CuriousMotor/Onyx-Stepper-Motherboard/Hardware/KiCAD Files/Onyx PCB Picture.png

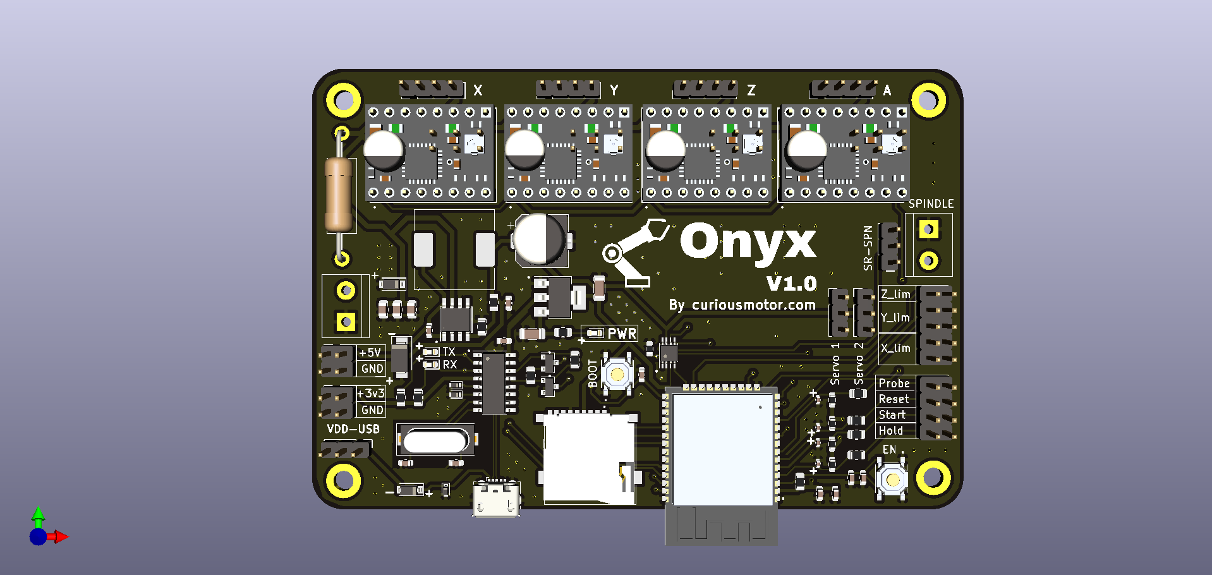
Hardware/KiCAD Files/Onyx PCB Picture.png
