CuriousMotor/Onyx-Stepper-Motherboard/Hardware/KiCAD Files/Resources/3D files/ESP32-WROOM-32D.step

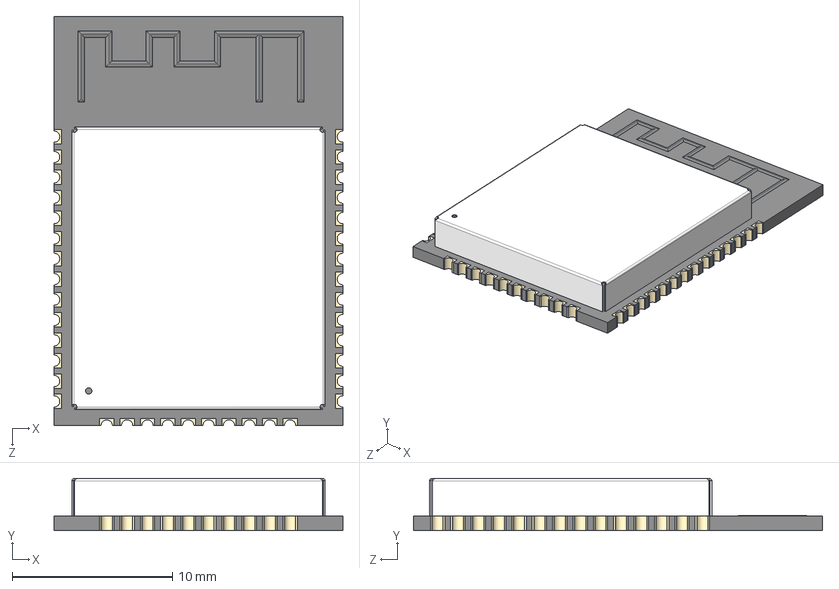
[picture p5: CAD file, 2021-12-19]
Hardware/KiCAD Files/Resources/3D files/ESP32-WROOM-32D.step
18.0 x 3.25 x 25.5 mm
