CuriousMotor/Onyx-Stepper-Motherboard/Hardware/KiCAD Files/Resources/ESP32-WROOM-32E__16MB_/ESP32-WROOM-32E__16MB_.step

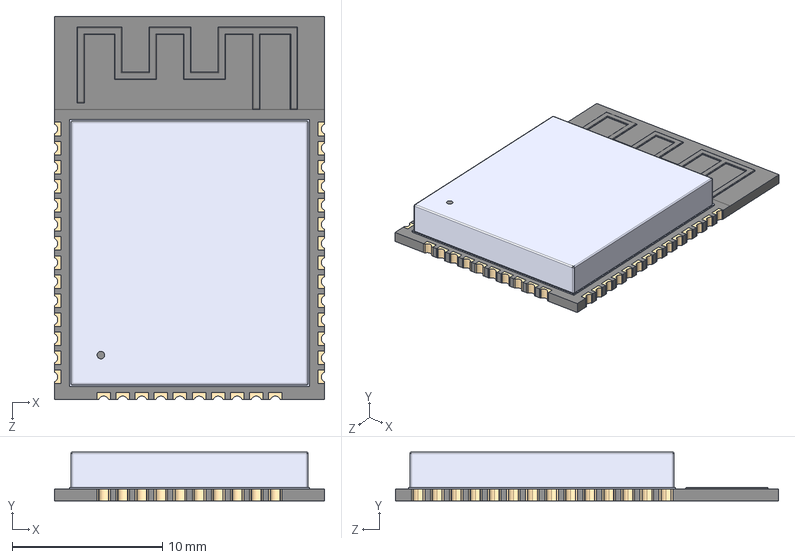
[picture p6: CAD file, 2021-12-19]
Hardware/KiCAD Files/Resources/ESP32-WROOM-32E__16MB_/ESP32-WROOM-32E__16MB_.step
18.0 x 3.25 x 25.5 mm
