CuriousMotor/Onyx-Stepper-Motherboard/Hardware/KiCAD Files/Resources/3D files/A4988_STEPPER_MOTOR_DRIVER_CARRIER.step

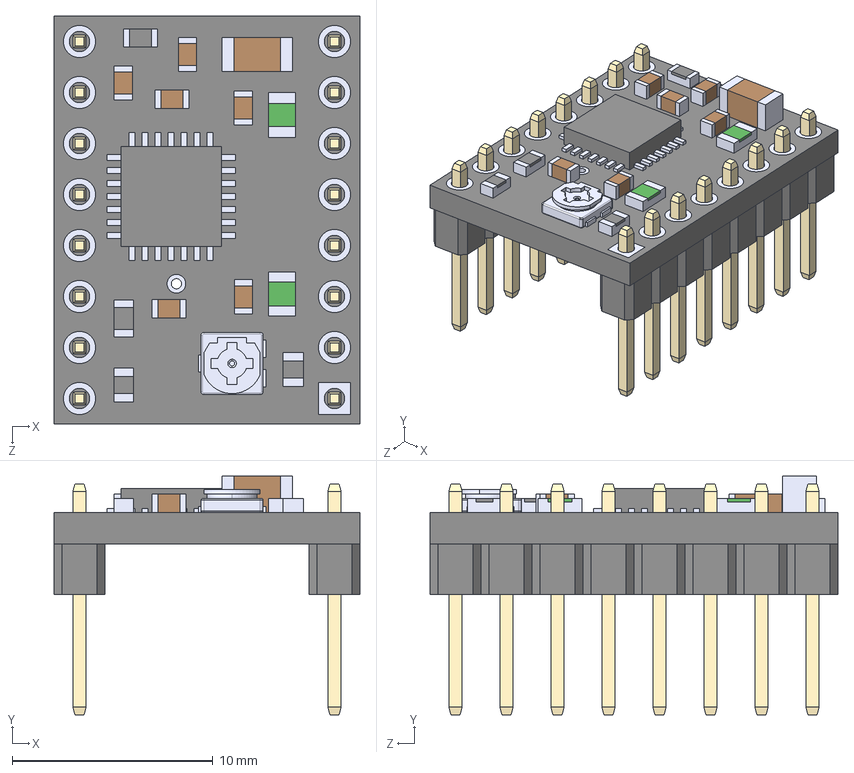
[picture p7: CAD file, 2021-12-19]
Hardware/KiCAD Files/Resources/3D files/A4988_STEPPER_MOTOR_DRIVER_CARRIER.step
15.2 x 11.9 x 20.3 mm
