CuriousMotor/Onyx-Stepper-Motherboard/Hardware/KiCAD Files/Resources/3D files/TS-1187A-B-A-B.step

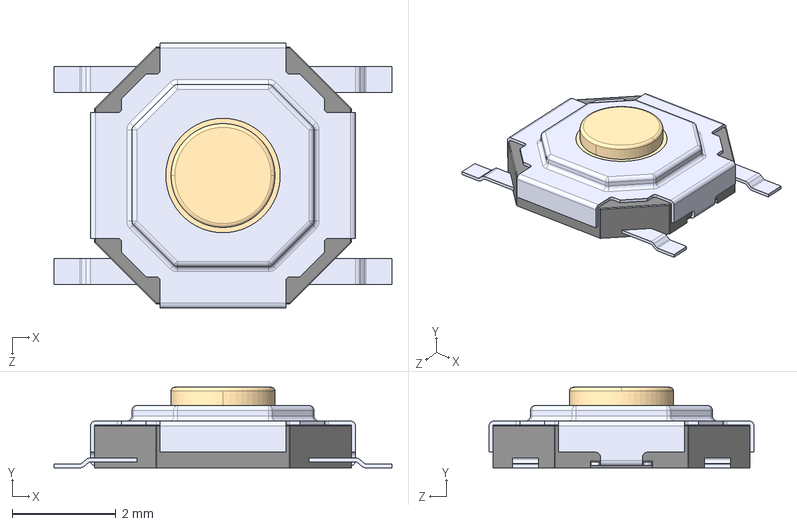
[picture p8: CAD file, 2021-12-19]
Hardware/KiCAD Files/Resources/3D files/TS-1187A-B-A-B.step
6.50 x 1.55 x 5.10 mm
