CuriousMotor/Onyx-Stepper-Motherboard/Hardware/OnyxV1_0_SCHEMATIC.pdf

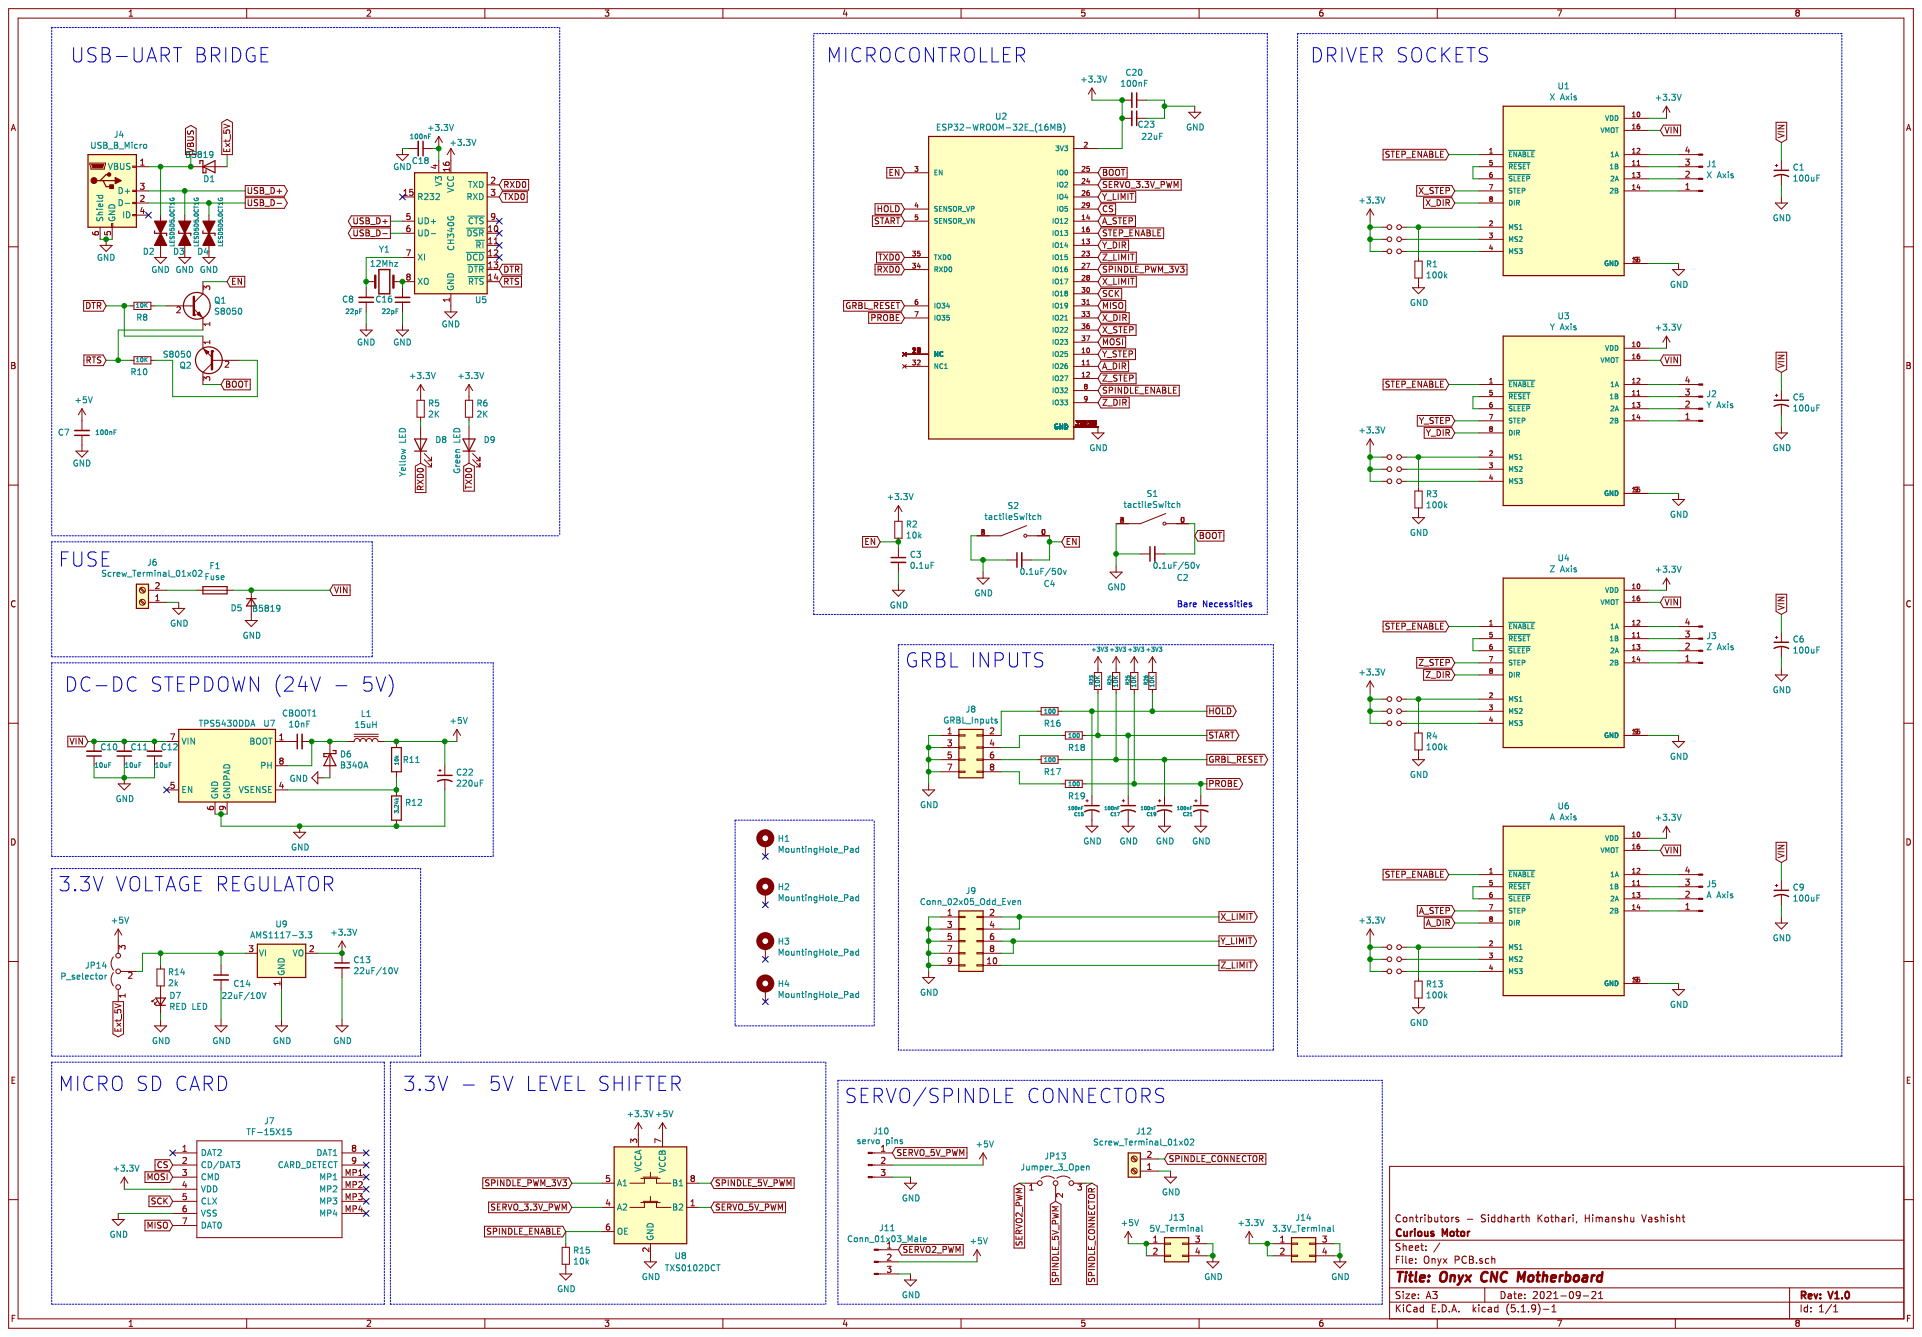
[picture p9: page 1]
