CuriousMotor/Onyx-Stepper-Motherboard/(list of files, drawings)

Other design files:
Hardware/KiCAD Files/Onyx PCB.dsn
