CuriousMotor/Onyx-Stepper-Motherboard/Hardware/KiCAD Files/Onyx PCB.kicad_pcb

## KiCad design Hardware/KiCAD Files/Onyx PCB.kicad_pcb (2022-01-01)

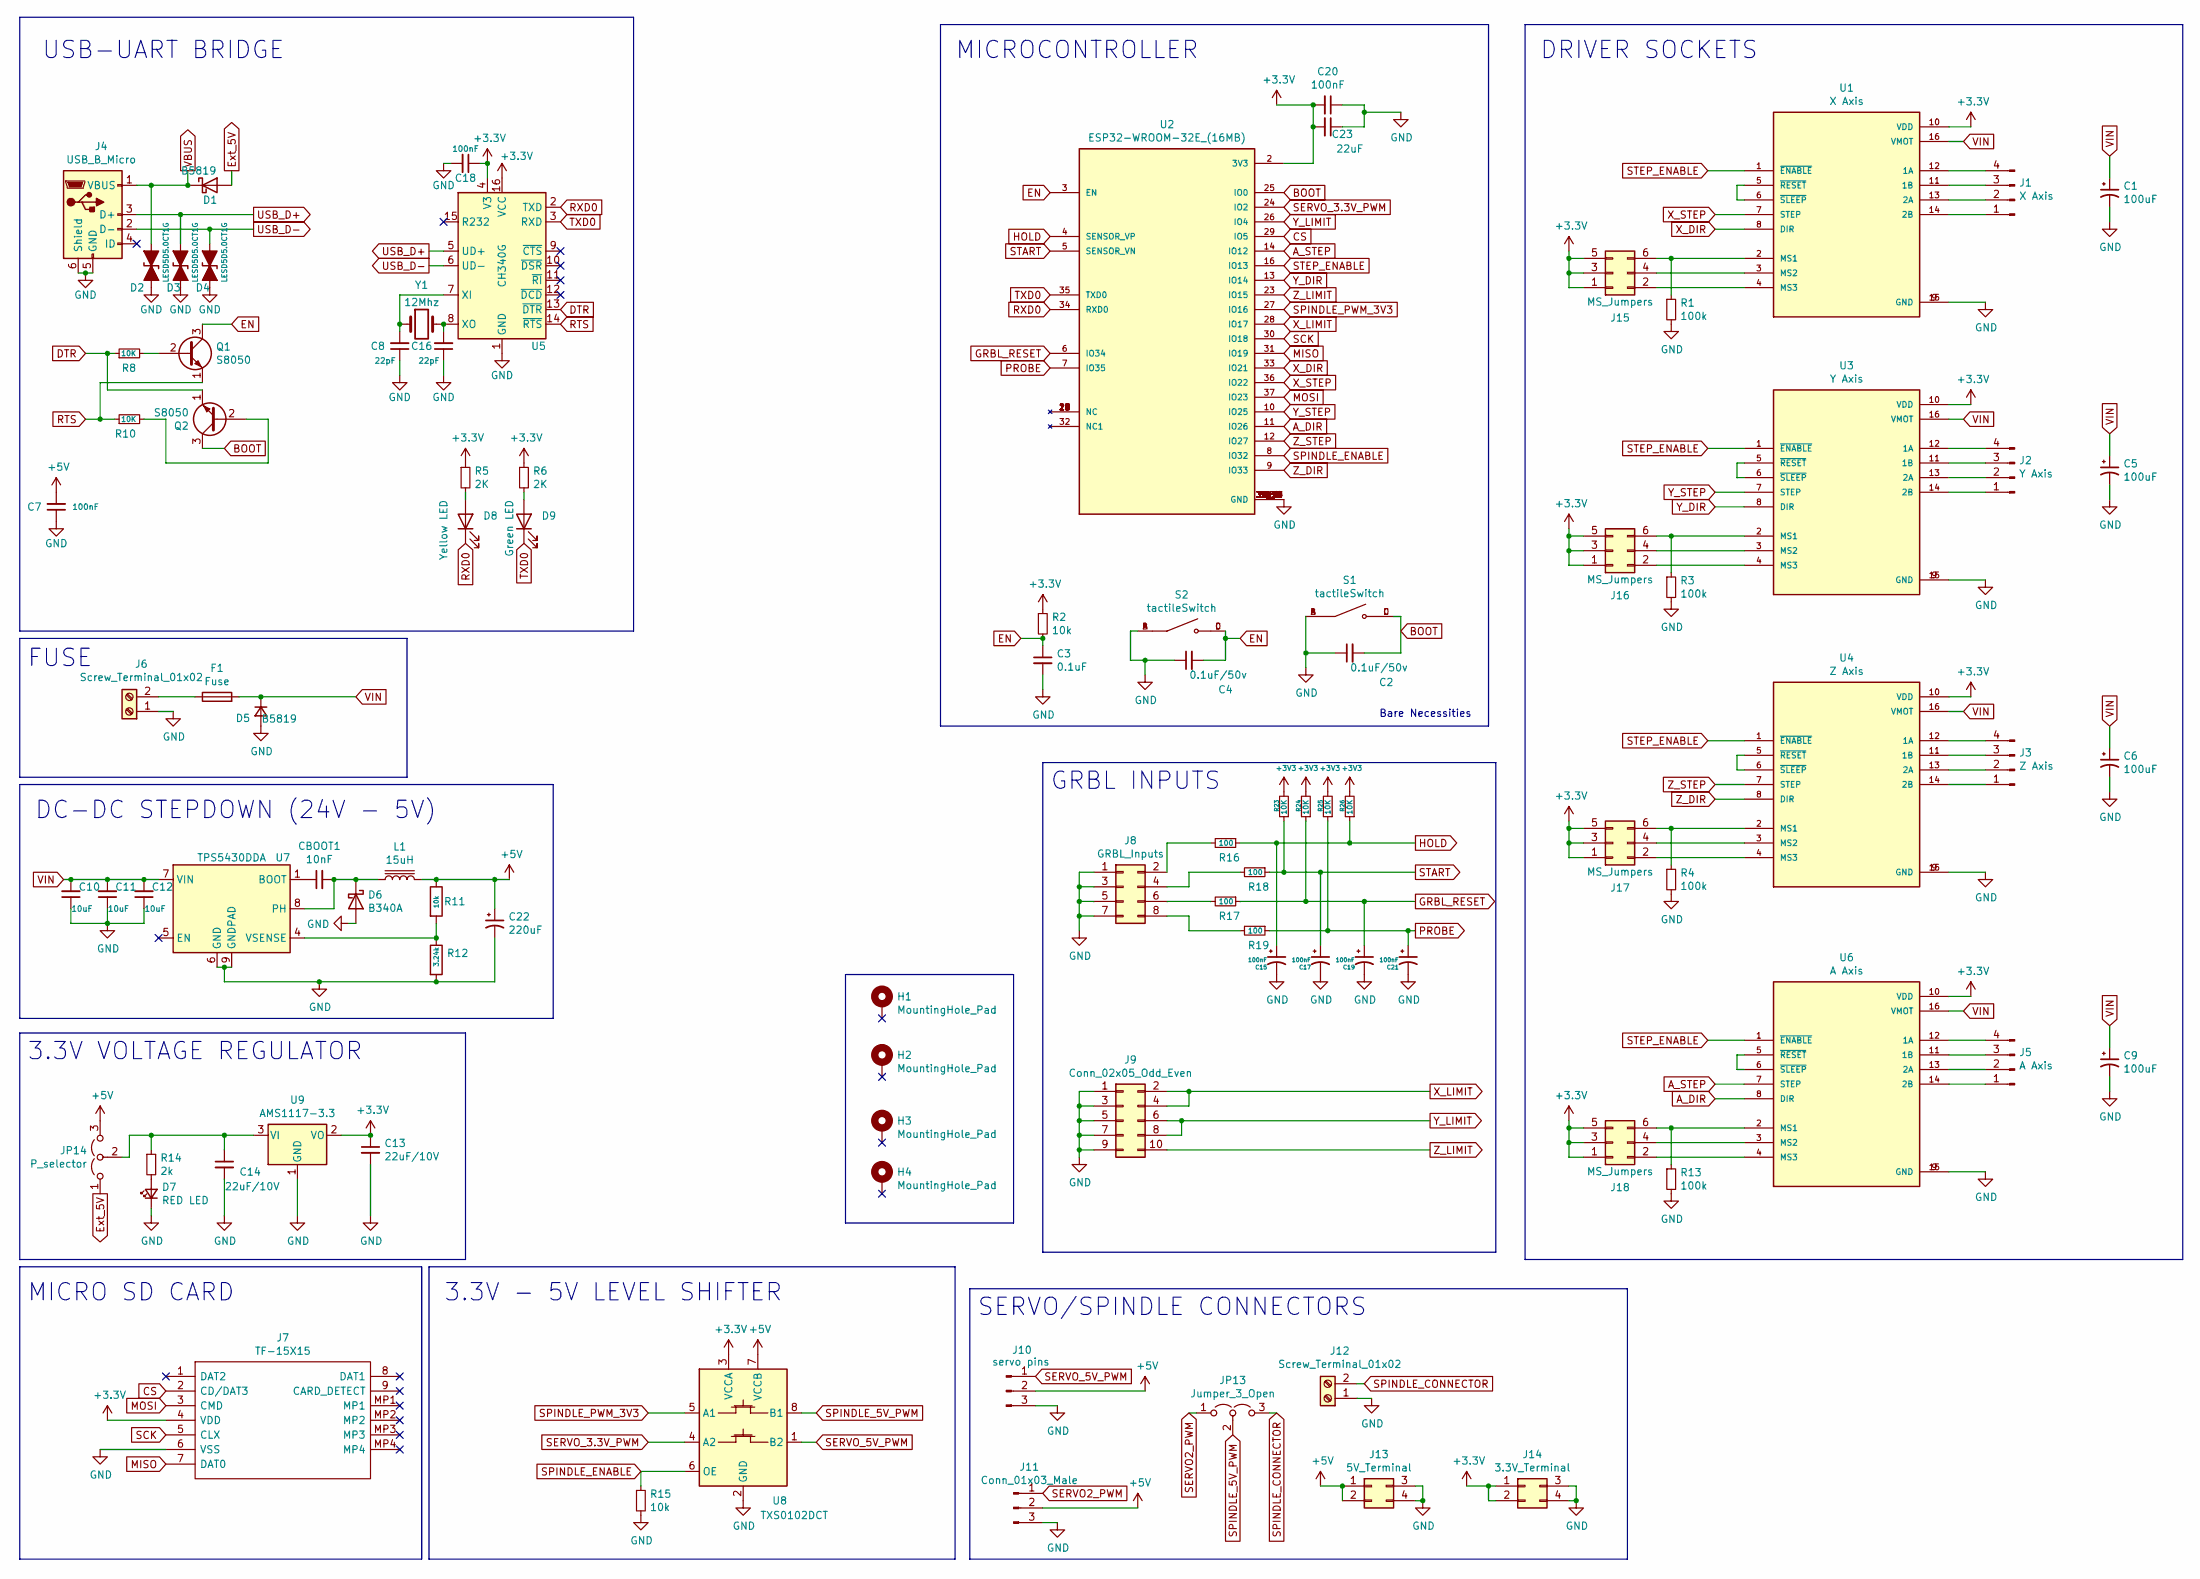
[picture p10: schematic Onyx PCB.kicad_sch, Onyx CNC Motherboard]

Parts:
C1, C5, C6, C9: 100uF; CP_Elec_6.3x7.7
C2, C4: 0.1uF/50v; C_0603_1608Metric
C3: 0.1uF; C_0603_1608Metric
C7, C18, C20: 100nF; C_0603_1608Metric
C8, C16: 22pF; C_0603_1608Metric
C10, C11, C12: 10uF; C_0805_2012Metric
C13, C14: 22uF/10V; C_1206_3216Metric
C15, C17, C19, C21: 100nF; C_0402_1005Metric
C22: 220uF; CP_Elec_8x10
C23: 22uF; C_0603_1608Metric; JLCPCB C59461
CBOOT1: 10nF; C_0603_1608Metric
D1, D5: B5819; D_SOD-123
D2, D3, D4: LESD5D5.0CT1G; D_SOD-523
D6: B340A; D_SMA
D7: RED LED; LED_0603_1608Metric
D8: Yellow LED; LED_0603_1608Metric
D9: Green LED; LED_0603_1608Metric
F1: Fuse; R_Axial_DIN0414_L11.9mm_D4.5mm_P20.32mm_Horizontal
H1, H2, H3, H4: MountingHole_Pad; MountingHole_3.2mm_M3_DIN965_Pad
J1: X Axis; PinHeader_1x04_P2.54mm_Vertical
J2: Y Axis; PinHeader_1x04_P2.54mm_Vertical
J3: Z Axis; PinHeader_1x04_P2.54mm_Vertical
J4: USB_B_Micro; USB_Micro-B_Amphenol_10118194_Horizontal; JLCPCB C132563
J5: A Axis; PinHeader_1x04_P2.54mm_Vertical
J6, J12: Screw_Terminal_01x02; TerminalBlock_bornier-2_P5.08mm
J7: TF-15X15; TF15X15; Manufacturer_Part_Number TF-15X15
J8: GRBL_Inputs; PinHeader_2x04_P2.54mm_Vertical
J9: Conn_02x05_Odd_Even; PinHeader_2x05_P2.54mm_Vertical
J10: servo pins; PinHeader_1x03_P2.54mm_Vertical
J11: Conn_01x03_Male; PinHeader_1x03_P2.54mm_Vertical
J13: 5V_Terminal; PinHeader_2x02_P2.54mm_Vertical
J14: 3.3V_Terminal; PinHeader_2x02_P2.54mm_Vertical
J15, J16, J17, J18: MS_Jumpers; PinHeader_2x03_P2.54mm_Vertical
JP13: Jumper_3_Open; PinHeader_1x03_P2.54mm_Vertical
JP14: P_selector; PinHeader_1x03_P2.54mm_Vertical
L1: 15uH; SWRH1207B; JLCPCB C115137
Q1, Q2: S8050; SOT-23
R1: 100k; R_0603_1608Metric; JLCPCB C25803
R2, R11: 10k; R_0805_2012Metric
R3, R4, R13: 100k; R_0603_1608Metric
R5, R6: 2K; R_0805_2012Metric
R8, R10: 10K; R_0805_2012Metric
R12: 3.24k; R_0805_2012Metric
R14: 2k; R_0805_2012Metric
R15: 10k; R_0603_1608Metric
R16, R17, R18, R19: 100; R_0805_2012Metric
R23, R24, R25, R26: 10K; R_0603_1608Metric
S1, S2: tactileSwitch; SW_TS-1187A-B-A-B; PARTREV A0
U1: X Axis; MODULE_A4988_STEPPER_MOTOR_DRIVER_CARRIER
U2: ESP32-WROOM-32E_(16MB); MODULE_ESP32-WROOM-32E_(16MB); PARTREV 1.1
U3: Y Axis; MODULE_A4988_STEPPER_MOTOR_DRIVER_CARRIER
U4: Z Axis; MODULE_A4988_STEPPER_MOTOR_DRIVER_CARRIER
U5: CH340G; SOIC-16_3.9x9.9mm_P1.27mm
U6: A Axis; MODULE_A4988_STEPPER_MOTOR_DRIVER_CARRIER
U7: TPS5430DDA; TI_SO-PowerPAD-8_ThermalVias
U8: TXS0102DCT; SSOP-8_2.95x2.8mm_P0.65mm
U9: AMS1117-3.3; SOT-223-3_TabPin2
Y1: 12Mhz; Crystal_SMD_HC49-SD; JLCPCB C188206

Connections:
+5V: C7.2, C22.1, J10.2, J11.2, J13.1, J13.2, JP14.3 (B), L1.2, R11.1, U8.7 (VCCB)
A_DIR: U2.11 (IO26), U6.8 (DIR)
A_STEP: U2.14 (IO12), U6.7 (STEP)
BOOT: C2.2, Q2.3 (C), S1.C, S1.D, U2.25 (IO0)
CS: J7.2 (CD/DAT3), U2.29 (IO5)
DTR: Q2.1 (E), R8.1, U5.13 (~DTR)
EN: C3.1, C4.2, Q1.3 (C), R2.2, S2.C, S2.D, U2.3 (EN)
Ext_5V: D1.2 (A), JP14.1 (A)
GND: C1.2, C2.1, C3.2, C4.1, C5.2, C6.2, C7.1, C8.1, C9.2, C10.1, C11.1, C12.1, C13.2, C14.2, C15.2, C16.1, C17.2, C18.2, C19.2, C20.1, C21.2, C22.2, C23.1, D2.2 (A2), D3.2 (A2), D4.2 (A2), D5.2 (A), D6.2 (A), D7.1 (K), J4.5 (GND), J4.6 (Shield), J6.1, J7.6 (VSS), J8.1, J8.3, J8.5, J8.7, J9.1, J9.3, J9.5, J9.7, J9.9, J10.3, J11.3, J12.1, J13.3, J13.4, J14.3, J14.4, R1.2, R3.2, R4.2, R12.2, R13.2, R15.2, S1.A, S1.B, S2.A, S2.B, U1.9 (GND), U1.15 (GND), U2.1 (GND), U2.15 (GND), U2.38 (GND), U2.39_1 (GND), U2.39_2 (GND), U2.39_3 (GND), U2.39_4 (GND), U2.39_5 (GND), U2.39_6 (GND), U2.39_7 (GND), U2.39_8 (GND), U2.39_9 (GND), U2.39_10 (GND), U2.39_11 (GND), U2.39_12 (GND), U2.39_13 (GND), U2.39_14 (GND), U2.39_15 (GND), U2.39_16 (GND), U2.39_17 (GND), U2.39_18 (GND), U2.39_19 (GND), U2.39_20 (GND), U2.39_21 (GND), U3.9 (GND), U3.15 (GND), U4.9 (GND), U4.15 (GND), U5.1 (GND), U6.9 (GND), U6.15 (GND), U7.6 (GND), U7.9 (GNDPAD), U8.2 (GND), U9.1 (GND)
GRBL_RESET: C19.1, R17.1, R24.1, U2.6 (IO34)
HOLD: C15.1, R16.1, R26.1, U2.4 (SENSOR_VP)
MISO: J7.7 (DAT0), U2.31 (IO19)
MOSI: J7.3 (CMD), U2.37 (IO23)
unnamed: C8.2, U5.7 (XI), Y1.1
unnamed: C14.1, JP14.2 (C), R14.1, U9.3 (VI)
unnamed: C16.2, U5.8 (XO), Y1.2
unnamed: CBOOT1.1, U7.1 (BOOT)
unnamed: CBOOT1.2, D6.1 (K), L1.1, U7.8 (PH)
unnamed: D7.2 (A), R14.2
unnamed: D8.2 (A), R5.2
unnamed: D9.2 (A), R6.2
unnamed: F1.1, J6.2
unnamed: J1.1, U1.14 (2B)
unnamed: J1.2, U1.13 (2A)
unnamed: J1.3, U1.11 (1B)
unnamed: J1.4, U1.12 (1A)
unnamed: J2.1, U3.14 (2B)
unnamed: J2.2, U3.13 (2A)
unnamed: J2.3, U3.11 (1B)
unnamed: J2.4, U3.12 (1A)
unnamed: J3.1, U4.14 (2B)
unnamed: J3.2, U4.13 (2A)
unnamed: J3.3, U4.11 (1B)
unnamed: J3.4, U4.12 (1A)
unnamed: J5.1, U6.14 (2B)
unnamed: J5.2, U6.13 (2A)
unnamed: J5.3, U6.11 (1B)
unnamed: J5.4, U6.12 (1A)
unnamed: J8.2, R16.2
unnamed: J8.4, R18.2
unnamed: J8.6, R17.2
unnamed: J8.8, R19.2
unnamed: J15.2, U1.4 (MS3)
unnamed: J15.4, U1.3 (MS2)
unnamed: J15.6, R1.1, U1.2 (MS1)
unnamed: J16.2, U3.4 (MS3)
unnamed: J16.4, U3.3 (MS2)
unnamed: J16.6, R3.1, U3.2 (MS1)
unnamed: J17.2, U4.4 (MS3)
unnamed: J17.4, U4.3 (MS2)
unnamed: J17.6, R4.1, U4.2 (MS1)
unnamed: J18.2, U6.4 (MS3)
unnamed: J18.4, U6.3 (MS2)
unnamed: J18.6, R13.1, U6.2 (MS1)
unnamed: Q1.2 (B), R8.2
unnamed: Q2.2 (B), R10.2
unnamed: R11.2, R12.1, U7.4 (VSENSE)
unnamed: U1.5 (~RESET), U1.6 (~SLEEP)
unnamed: U3.5 (~RESET), U3.6 (~SLEEP)
unnamed: U4.5 (~RESET), U4.6 (~SLEEP)
unnamed: U6.5 (~RESET), U6.6 (~SLEEP)
PROBE: C21.1, R19.1, R25.1, U2.7 (IO35)
RTS: Q1.1 (E), R10.1, U5.14 (~RTS)
RXD0: D8.1 (K), U2.34 (RXD0), U5.2 (TXD)
SCK: J7.5 (CLX), U2.30 (IO18)
SERVO2_PWM: J11.1, JP13.1 (A)
SERVO_3.3V_PWM: U2.24 (IO2), U8.4 (A2)
SERVO_5V_PWM: J10.1, U8.1 (B2)
SPINDLE_5V_PWM: JP13.2 (C), U8.8 (B1)
SPINDLE_CONNECTOR: J12.2, JP13.3 (B)
SPINDLE_ENABLE: R15.1, U2.8 (IO32), U8.6 (OE)
SPINDLE_PWM_3V3: U2.27 (IO16), U8.5 (A1)
START: C17.1, R18.1, R23.1, U2.5 (SENSOR_VN)
STEP_ENABLE: U1.1 (~ENABLE), U2.16 (IO13), U3.1 (~ENABLE), U4.1 (~ENABLE), U6.1 (~ENABLE)
TXD0: D9.1 (K), U2.35 (TXD0), U5.3 (RXD)
USB_D+: D3.1 (A1), J4.3 (D+), U5.5 (UD+)
USB_D-: D4.1 (A1), J4.2 (D-), U5.6 (UD-)
VBUS: D1.1 (K), D2.1 (A1), J4.1 (VBUS)
VIN: C1.1, C5.1, C6.1, C9.1, C10.2, C11.2, C12.2, D5.1 (K), F1.2, U1.16 (VMOT), U3.16 (VMOT), U4.16 (VMOT), U6.16 (VMOT), U7.7 (VIN)
X_DIR: U1.8 (DIR), U2.33 (IO21)
X_LIMIT: J9.2, J9.4, U2.28 (IO17)
X_STEP: U1.7 (STEP), U2.36 (IO22)
Y_DIR: U2.13 (IO14), U3.8 (DIR)
Y_LIMIT: J9.6, J9.8, U2.26 (IO4)
Y_STEP: U2.10 (IO25), U3.7 (STEP)
Z_DIR: U2.9 (IO33), U4.8 (DIR)
Z_LIMIT: J9.10, U2.23 (IO15)
Z_STEP: U2.12 (IO27), U4.7 (STEP)

Notes on the sheet:
DRIVER SOCKETS
Bare Necessities
3.3V VOLTAGE REGULATOR
FUSE
SERVO/SPINDLE CONNECTORS
3.3V - 5V LEVEL SHIFTER
MICRO SD CARD
MICROCONTROLLER
DC-DC STEPDOWN (24V - 5V)
USB-UART BRIDGE
GRBL INPUTS

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
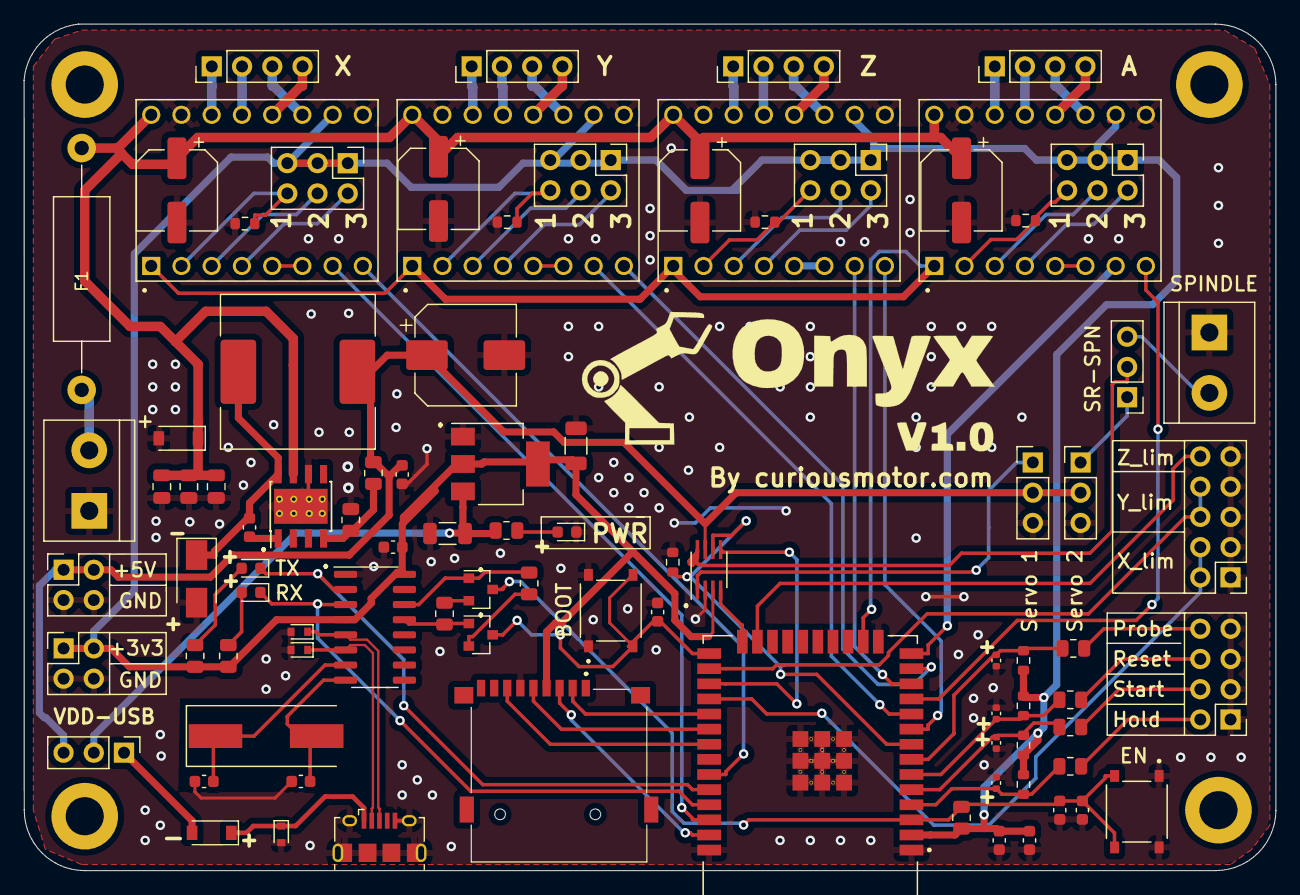
[picture p11: board Onyx PCB.kicad_pcb from above]

Board: 2 copper layers, 105.2 x 71.1 mm, 94 parts (0 on the bottom side), 89 nets.
