CuriousMotor/Onyx-Stepper-Motherboard/(commit log)

2021-12-15 Added readMe
    [alarm_codes_en_US.csv, build_option_codes_en_US.csv, error_codes_en_US.csv, setting_codes_en_US.csv]
2021-12-19 Added Hardware files
    [A4988_STEPPER_MOTOR_DRIVER_CARRIER.step, ESP32-WROOM-32D.step, ESP32-WROOM-32E__16MB_.step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]
2021-12-19 Added more GND Vias
    [Onyx PCB.kicad_pcb]
2021-12-21 Re-created step file with corrected drivers
    [Onyx PCB.kicad_pcb]
2021-12-30 Changed individual MS-config jumpers to blocks for easier soldering
    [Onyx PCB.kicad_pcb, Onyx PCB.kicad_sch]
2022-01-01 Updated 3D model
    [Onyx PCB.kicad_pcb]
